DobrisorViorel/Project-1---Electronic-Devices-and-Circuits/Simulations/simulare curenti.jpg

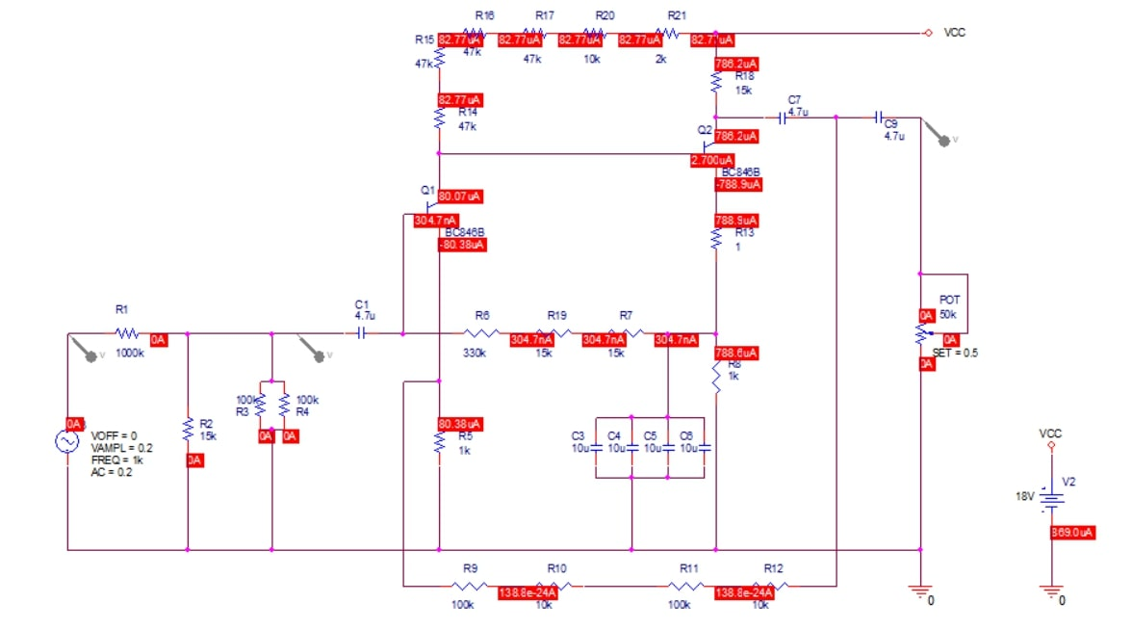
Simulations/simulare curenti.jpg
