DobrisorViorel/Project-1---Electronic-Devices-and-Circuits/Simulations/simulare frecventa temp.jpg

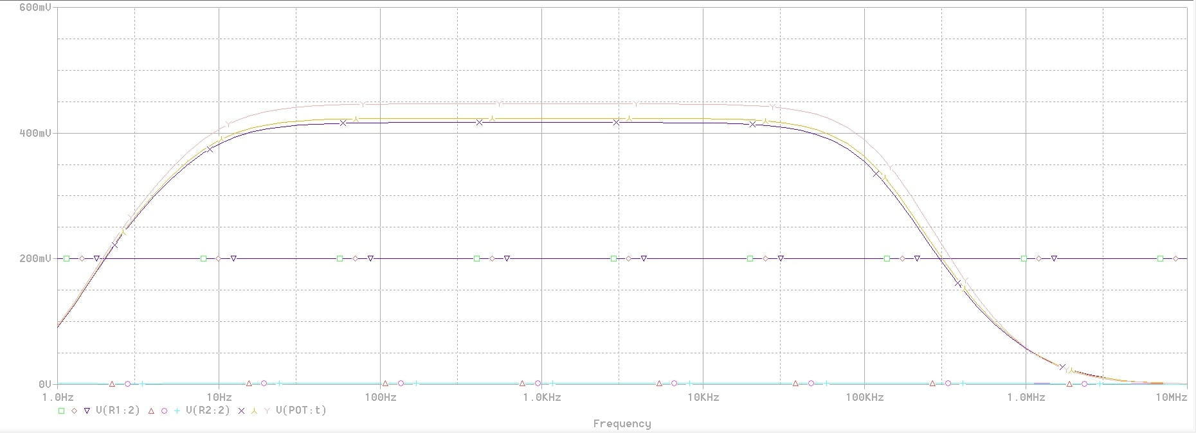
Simulations/simulare frecventa temp.jpg
