DobrisorViorel/Project-1---Electronic-Devices-and-Circuits/Simulations/simulare frecventa.jpg

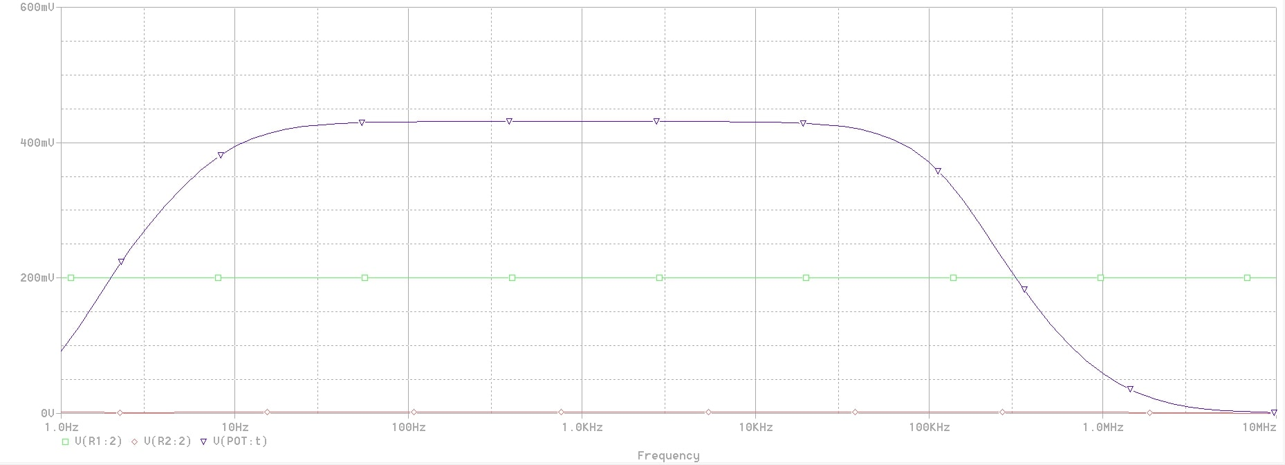
Simulations/simulare frecventa.jpg
