DobrisorViorel/Project-1---Electronic-Devices-and-Circuits/Simulations/simulare puteri.jpg

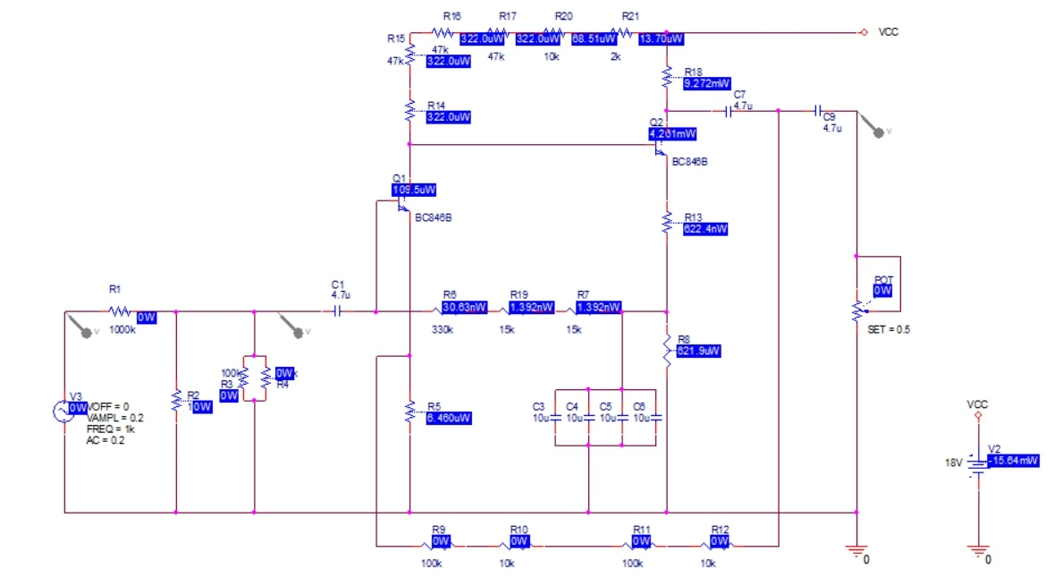
Simulations/simulare puteri.jpg
