DobrisorViorel/Project-1---Electronic-Devices-and-Circuits/Simulations/simulare tensiuni.jpg

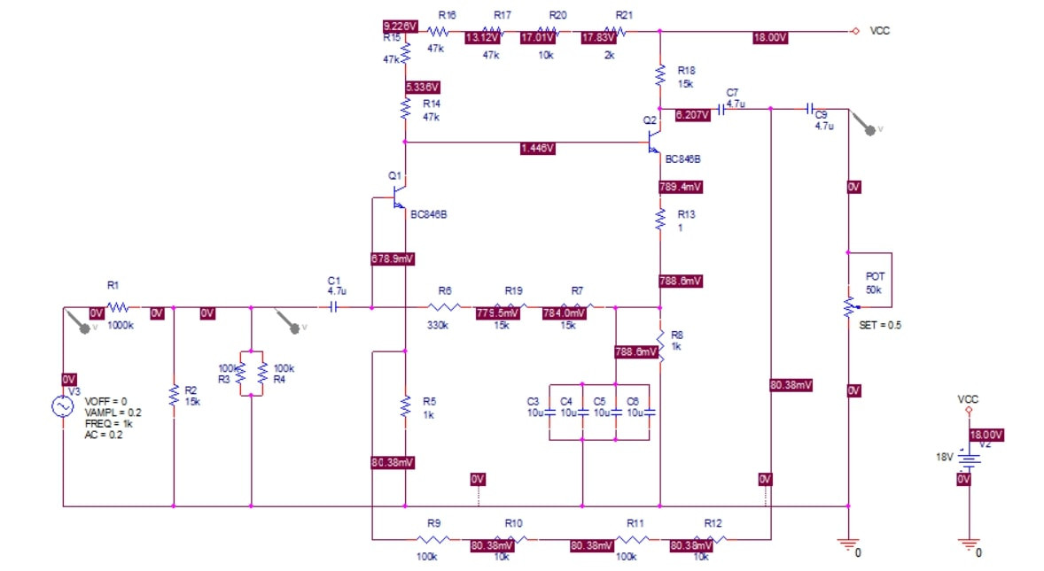
Simulations/simulare tensiuni.jpg
