DobrisorViorel/Project-1---Electronic-Devices-and-Circuits/Simulations/simulare timp temp.jpg

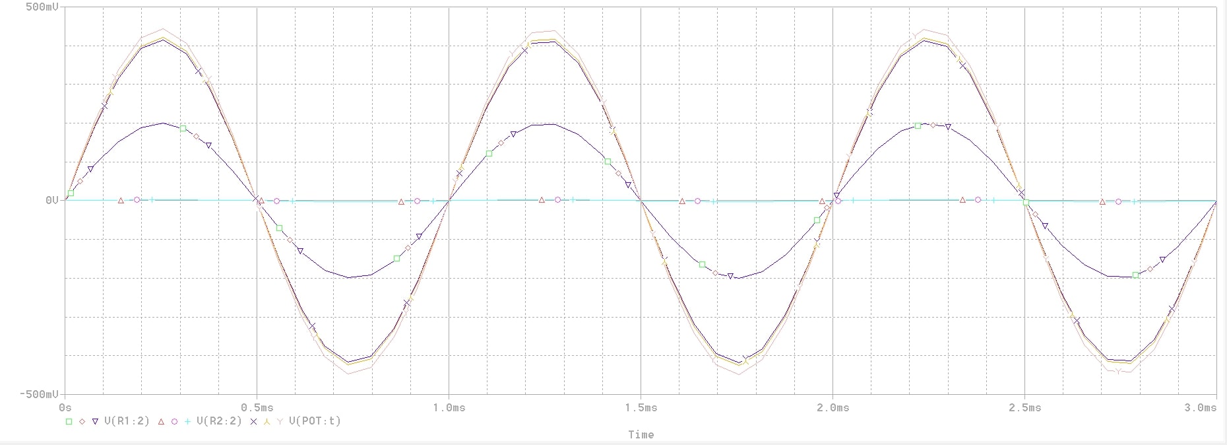
Simulations/simulare timp temp.jpg
