DobrisorViorel/Project-1---Electronic-Devices-and-Circuits/Schematics/PAI/Pai-PSpiceFiles/SCHEMATIC1/freq/freq.cir

** Profile: "SCHEMATIC1-freq"  [ C:\Users\UTILIZATOR\Desktop\Proiect - Copy\pai-pspicefiles\schematic1\freq.sim ] 

** Creating circuit file "freq.cir" 
** WARNING: THIS AUTOMATICALLY GENERATED FILE MAY BE OVERWRITTEN BY SUBSEQUENT SIMULATIONS

*Libraries: 
* Profile Libraries :
* Local Libraries :
* From [PSPICE NETLIST] section of C:\Users\UTILIZATOR\AppData\Roaming\SPB_Data\cdssetup\OrCAD_PSpice\17.2.0\PSpice.ini file:
.lib "nomd.lib" 

*Analysis directives: 
.AC DEC 10 1 10meg
.OPTIONS ADVCONV
.PROBE64 V(alias(*)) I(alias(*)) W(alias(*)) D(alias(*)) NOISE(alias(*)) 
.INC "..\SCHEMATIC1.net" 


.END
