DobrisorViorel/Project-1---Electronic-Devices-and-Circuits/Schematics/PAI/Pai-PSpiceFiles/SCHEMATIC1/psf/psf.cir

** Profile: "SCHEMATIC1-psf"  [ C:\Users\UTILIZATOR\Desktop\Proiect PAI24\pai-pspicefiles\schematic1\psf.sim ] 

** Creating circuit file "psf.cir" 
** WARNING: THIS AUTOMATICALLY GENERATED FILE MAY BE OVERWRITTEN BY SUBSEQUENT SIMULATIONS

*Libraries: 
* Profile Libraries :
* Local Libraries :
* From [PSPICE NETLIST] section of C:\Users\UTILIZATOR\AppData\Roaming\SPB_Data\cdssetup\OrCAD_PSpice\17.2.0\PSpice.ini file:
.lib "nomd.lib" 

*Analysis directives: 
.OPTIONS ADVCONV
.PROBE64 V(alias(*)) I(alias(*)) W(alias(*)) D(alias(*)) NOISE(alias(*)) 
.INC "..\SCHEMATIC1.net" 


.END
