DobrisorViorel/Project-1---Electronic-Devices-and-Circuits/(list of files, drawings)

Other design files:
Schematics/PAI/PAI.DSN
Schematics/PAI/Pai.opj
Schematics/Schema layout/PCB.DSN
Schematics/Schema layout/pcb.opj
